iayanpahwa/Automated_Plant_Watering_System/README.md

Automated_Plant_Watering_System
===============================

Solar based plant watering feeder based on soil moisture analog sensors. Published in Electronics for you magazine november,2014 issue.
