iayanpahwa/Automated_Plant_Watering_System/Const-2_Automated Plant Watering.pdf

## dIy: project

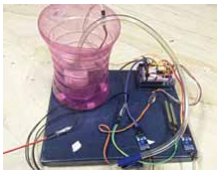
[picture p1: figure]
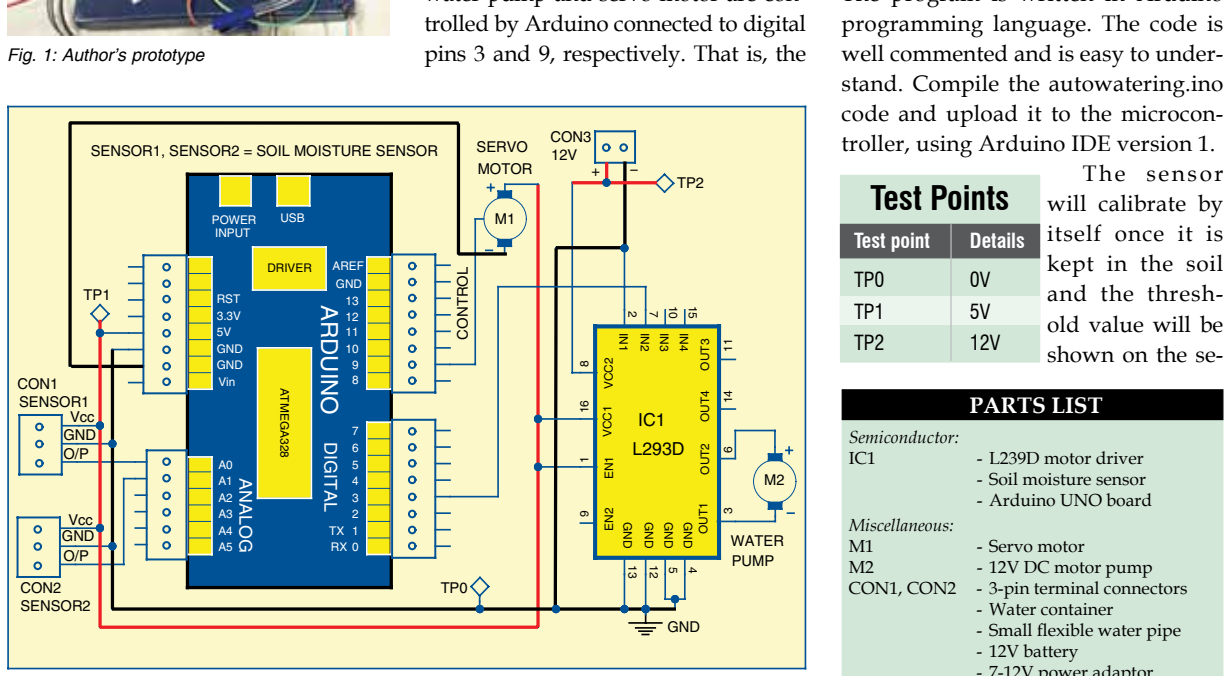
[picture p2: figure]
programming language. The code is well commented and is easy to under- stand. Compile the autowatering.ino code and upload it to the microcon- troller, using Arduino IDE version 1. The sensor will calibrate by itself once it is kept in the soil and the thresh- old value will be shown on the se-; trolled by Arduino connected to digital; Fig. 1: Author’s prototype; POWER; USB; DRIVER ATMEGA328; AREF GND 13 12 11 10 9 8; RST 3.3V 5V GND GND Vin; INPUT; RX ARDUINO DIGITAL; ANALOG; 4 GND; OUT2; 5 GND; VCC2; OUT4; 13 GND; 12 GND; OUT3; OUT1; VCC1; SERVO MOTOR; WATER; CON3 12V; CON1 SENSOR1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

www.efymag.com | Electronics For You | November 2014 93

servo motor signal control pin is connected to pin 9 of the Arduino board. The program in the Arduino reads the moisture value from the sensor every 20 seconds. If the value reaches the threshold value, the program does the following three things:
1. It moves the servo motor horn, along with the water pipe fixed on it, toward potted plant, whose moisture level is less than the predetermined/ threshold level.
2. It starts the motor pump to supply water to the plant for a fixed period of time and then stops the water pump (refer Fig. 4).
3. It brings back the servo motor horn to its initial position.

### Software program

The program is written in Arduino

# Automated Plants Watering System

Ayan Pahwa
Abhijeet Rai
2. The circuit comprises an Arduino UNO board, a soil moisture sensor, a servo motor, a 12V water pump and an L293D (IC1) motor driver IC to run the water pump.
You can power the Arduino board using a 7V to 12V wall wart or plugin adaptor or solar panel. You need a separate 12V battery or power supply or solar panel for the pump motor. Soil moisture sensor. Two types of soil moisture sensors are available in the market—contact and non-contact sensors. A contact soil sensor (as shown in Fig. 3) is used in this project because it has to check soil moisture to measure the electrical conductivity. The moisture sensor provides an analogue output, which can easily be interfaced with Arduino. In this project, two sensors can be connected to analogue pins, A0 and A1, of the Arduino board. Each sensor has four pins (Vcc, Gnd, Ao and Do) available for interfacing with the Arduino board. Here, digital output pin (Do) is not used. The water pump and servo motor are con-

pins 3 and 9, respectively. That is, the

During summers, most people

are too lazy to water the potted plants on their rooftop gardens every day. Explained in this section is a simple and exciting plant watering system that you can build yourself in just a few hours. It is an Arduino based automatic plant waterfeeder system that uses a soil moisture sensor. The author’s prototype is shown in Fig. 1.

### Circuit and working

The circuit diagram of the automated plant watering system is shown in Fig.

Fig. 2: Circuit diagram of the automated plants watering system

- 7-12V power adaptor

## dIy: project

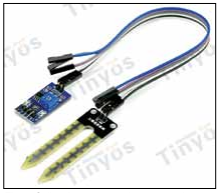
[picture p3: figure]
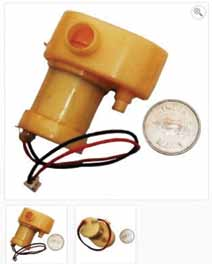
[picture p4: figure]
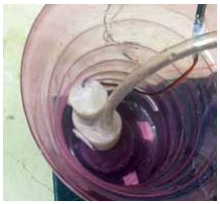
[picture p5: figure]
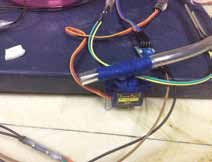
[picture p6: figure]

94 | November 2014 | Electronics For You | www.efymag.com

ted plants. Do not immerse the sensors fully inside the soil.
Install the pump in a water container (refer Fig. 7) that can hold a few litres of water. attach the water pipe on the servo motor horn as shown in Fig. 8.
Before powering the circuit on, you rial monitor in Arduino. Serial debugging is available in this program. Comment out if you do not wish to use the serial monitor.

### Construction and testing

An actual-size, single-side PCB layout of the automated plant watering system is shown in Fig. 5 and its component layout in Fig. 6.
Assemble the components on the PCB to minimise errors. Alternatively, you can assemble them on a breadboard or Arduino prototyping shield or a general-purpose PCB. Upload the code to Arduino UNO board and install the sensors in the soil of the pot-

Fig. 7: Installing water pump in the container

Fig. 8: Attaching the pipe on the servo horn

### efy Note

The source code of this project is included in this month’s EFY DVD and is also available for free download at source.efymag.com

Fig. 3: Soil moisture sensor (contact type)

Fig. 4: Motor pump

Fig. 5: Actual-size PCB layout of the circuit

Fig. 6: Component layout of the PCB need to keep in mind the following macro definitions in the code:
1. Changing the angle of rotation of the servo horn toward the first pot and second pot. The default values are 70 degrees and 145 degrees.
2. Changing the watering time according to the size of the pot. The default values are five seconds and eight seconds.
3. Changing the threshold value according to your need. The default value is 600.
Place the flower pots where the pipe from the servo motor horn can easily reach them. When the moisture level dips below 600, servo horn rotates at an angle of 70 degrees. That is, after servo motor horn moves 70 degrees toward the first pot, the motor pump will be on for five seconds and then stop automatically. Then, the servo returns to its original position. Similarly, if you are using a second sensor, the servo motor horn will move to 145 degrees to the second biggest pot, motor pump will be on for eight seconds and then stop automatically. The servo returns to its original position.

### Further application

Using the Arduino UNO board, you can water six different potted plants. By adding a few more lines in the code, you can water even more plants—by using the Arduino Mega 2560 board which has more analogue input pins.
You can also add an Ethernet or Wi-Fi shield and use the Twitter library, which will tweet from your plants side to send messages like: I need water, tank is empty, refill the tank, thanks for the water, and so on.
You can also add a 16×2 LCD to indicate moisture levels.
You can also enable the circuit to refill the tank after a few days, depending on the volume of the tank. ●

The author is a student of applied electronics and instrumentation engineering at JRE School of Engineering, Greater Noida. He likes making projects with Arduino
